zmolnar/g-track/hardware/KiCad/v1.0/g-track_.html

## KiBoM PCB Bill of Materials

Source File | /home/zmolnar/development/KiCad/g-track/g-track/g-track.sch
BoM Date | 2019. febr. 6., szerda, 18:45:01 CET
Schematic Version
Schematic Date
KiCad Version | Eeschema 5.0.2-bee76a0~70~ubuntu18.04.1
Component Groups | 61
Component Count (per PCB) | 101
Fitted Components (per PCB) | 101
Number of PCBs | 1
Total Component Count (for 1 PCBs) | 101

## Component Groups

KiCad Fields (default)

Generated Fields

User Fields

Empty Fields

| Description | Part | References | Value | Footprint | Quantity Per PCB | Datasheet | Lomex | Farnell
1 | Unpolarized capacitor, small symbol | C_Small | C13 C18 C19 C20 C21 C23 C25 C27 | 100nF | C_0603_1608Metric_Pad1.05x0.95mm_HandSolder | 8 | ~ | 82-06-23 82-03-47
2 | Unpolarized capacitor, small symbol | C_Small | C5 C14 C32 | 100nF | C_0805_2012Metric_Pad1.15x1.40mm_HandSolder | 3 | ~ | ? 82-01-75
3 | Unpolarized capacitor, small symbol | C_Small | C30 | 100nF/50V | C_0805_2012Metric_Pad1.15x1.40mm_HandSolder | 1 | ~ | 82-01-75
4 | Unpolarized capacitor, small symbol | C_Small | C26 | 10uF | C_0603_1608Metric_Pad1.05x0.95mm_HandSolder | 1 | ~ | 82-11-15
5 | Unpolarized capacitor, small symbol | C_Small | C1 C17 C29 | 10uF/25V | C_1206_3216Metric_Pad1.42x1.75mm_HandSolder | 3 | ~ | 82-07-90
6 | Unpolarized capacitor, small symbol | C_Small | C9 C10 | 12pF | C_0603_1608Metric_Pad1.05x0.95mm_HandSolder | 2 | ~ | 82-12-68
7 | Unpolarized capacitor, small symbol | C_Small | C4 | 15nF | C_0805_2012Metric_Pad1.15x1.40mm_HandSolder | 1 | ~ | 82-01-22
8 | Unpolarized capacitor, small symbol | C_Small | C22 C24 | 1uF | C_0603_1608Metric_Pad1.05x0.95mm_HandSolder | 2 | ~ | 82-06-81
9 | Unpolarized capacitor, small symbol | C_Small | C28 | 2.2uF | C_0805_2012Metric_Pad1.15x1.40mm_HandSolder | 1 | ~ | 82-04-35
10 | Unpolarized capacitor, small symbol | C_Small | C2 | 220pF | C_0805_2012Metric_Pad1.15x1.40mm_HandSolder | 1 | ~ | 82-05-54
11 | Unpolarized capacitor, small symbol | C_Small | C11 C12 | 22pF | C_0603_1608Metric_Pad1.05x0.95mm_HandSolder | 2 | ~ | 82-06-55
12 | Unpolarized capacitor, small symbol | C_Small | C7 C33 | 470nF | C_0805_2012Metric_Pad1.15x1.40mm_HandSolder | 2 | ~ | 82-06-60
13 | Polarized capacitor, small US symbol | CP1_Small | C6 | 470uF | CP_Elec_8x10 | 1 | ~ | 91-00-97
14 | Polarized capacitor, small US symbol | CP1_Small | C8 C31 C34 | 47uF | CP_EIA-3528-21_Kemet-B_Pad1.50x2.35mm_HandSolder | 3 | ~ | 92-01-24
15 | Unpolarized capacitor, small symbol | C_Small | C3 | 56pF | C_0805_2012Metric_Pad1.15x1.40mm_HandSolder | 1 | ~ | 82-01-00
16 | Schottky diode | D_Schottky | D1 D4 | B340A | D_SMA | 2 | ~ | | 2748288
17 | Light emitting diode | LED | D2 D3 D6 | GREEN | D_0603_1608Metric_Pad1.05x0.95mm_HandSolder | 3 | ~
18 | 100V 0.1A Small Signal Schottky diode, MiniMELF | LL41 | D7 | LL46 | D_MiniMELF | 1 | http://www.vishay.com/docs/85659/bat41.pdf
19 | Light emitting diode | LED | D8 | RED | D_0603_1608Metric_Pad1.05x0.95mm_HandSolder | 1 | ~
20 | Generic connector, single row, 01x04, script generated (kicad-library-utils/schlib/autogen/connector/) | Conn_01x04 | J4 | DCM | Tianli_TLPHC100R_1x04_P3.81mm_Horizontal | 1 | ~ | 43-27-91
21 | Generic connector, single row, 01x10, script generated (kicad-library-utils/schlib/autogen/connector/) | Conn_01x10 | J5 | EXT | Tianli_TLPHC100R_1x10_P3.81mm_Horizontal | 1 | ~
22 | Generic connector, single row, 01x08, script generated (kicad-library-utils/schlib/autogen/connector/) | Conn_01x08 | J8 | LIS3DSH | PinHeader_1x08_P2.54mm_Vertical | 1 | ~
23 | Micro SD Card Socket with card detection pins | Micro_SD_Card_Det | J3 | Micro SD card | microSD_HC_Hirose_DM3AT-SF-PEJM5 | 1 | https://www.hirose.com/product/en/download_file/key_name/DM3/category/Catalog/doc_file_id/49662/?item_id=195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 | | 1764374
24 | Generic connector, single row, 01x06, script generated (kicad-library-utils/schlib/autogen/connector/) | Conn_01x06 | J1 | SWD | PinSocket_1x06_P2.54mm_Vertical | 1 | ~
25 | USB Mini Type B connector | USB_B_Mini | J2 | USB_B_Mini | USB_Mini-B_Lumberg_2486_01_Horizontal | 1 | ~
26 | expansion header for Raspberry Pi 2 & 3 | Raspberry_Pi_2_3 | J6 | Waveshare GSM/GPS/GNSS | Waveshare_GSM_GPS_GNSS_hat | 1 | https://www.raspberrypi.org/documentation/hardware/raspberrypi/schematics/rpi_SCH_3bplus_1p0_reduced.pdf
27 | Jumper, 3-pole, both open | Jumper_3_Open | JP3 | ACC_SPI_SELECT | PinHeader_1x03_P1.00mm_Vertical | 1 | ~
28 | Jumper, 3-pole, both open | Jumper_3_Open | JP1 | Power source | PinHeader_1x03_P2.54mm_Vertical | 1 | ~
29 | Solder Jumper, 3-pole, open | SolderJumper_3_Open | JP2 | Protection | SolderJumper-3_P2.0mm_Open_TrianglePad1.0x1.5mm_NumberLabels | 1 | ~
30 | Capacitor symbol for simulation only | INDUCTOR | L1 | 22uH | L_Bourns_SRR1260 | 1 | ~ | | 2374126
31 | 0.115A Id, 60V Vds, N-channel MOSFET, SOT-23 | 2N7002 | Q1 Q2 | 2N7002 | SOT-23 | 2 | https://www.fairchildsemi.com/datasheets/2N/2N7002.pdf
32 | Resistor, small symbol | R_Small | R30 R31 | 0R47 | R_0805_2012Metric_Pad1.15x1.40mm_HandSolder | 2 | ~ | 80-18-24
33 | Resistor, small symbol | R_Small | R21 | 100k | R_0805_2012Metric_Pad1.15x1.40mm_HandSolder | 1 | ~ | 81-34-64
34 | Resistor | R | R6 R15 R22 R26 R27 R28 R29 R39 R40 | 10k | R_0805_2012Metric_Pad1.15x1.40mm_HandSolder | 9 | ~ | 80-52-96
35 | Resistor, small symbol | R_Small | R8 | 10k | R_0603_1608Metric_Pad1.05x0.95mm_HandSolder | 1 | ~ | 81-10-38
36 | Resistor, small symbol | R_Small | R2 R35 R36 R37 | 15k | R_0805_2012Metric_Pad1.15x1.40mm_HandSolder | 4 | ~ | 80-11-00
37 | Resistor, small symbol | R_Small | R14 | 160R | R_0805_2012Metric_Pad1.15x1.40mm_HandSolder | 1 | ~ | 80-01-97
38 | Resistor | R | R7 | 1k91 | R_0805_2012Metric_Pad1.15x1.40mm_HandSolder | 1 | ~ | | 2138373
39 | Resistor, small symbol | R_Small | R32 R33 R34 | 2k | R_0805_2012Metric_Pad1.15x1.40mm_HandSolder | 3 | ~ | 80-36-87
40 | Resistor, small symbol | R_Small | R10 R11 R25 R38 | 330R | R_0805_2012Metric_Pad1.15x1.40mm_HandSolder | 4 | ~ | 80-32-56
41 | Resistor, small symbol | R_Small | R3 | 332k | R_0805_2012Metric_Pad1.15x1.40mm_HandSolder | 1 | ~ | 80-03-06
42 | Resistor, small symbol | R_Small | R23 | 33k | R_0805_2012Metric_Pad1.15x1.40mm_HandSolder | 1 | ~ | 81-11-05
43 | Resistor, small symbol | R_Small | R9 | 390R | R_0603_1608Metric_Pad1.05x0.95mm_HandSolder | 1 | ~ | 81-10-21
44 | Resistor, small symbol | R_Small | R5 | 40k2 | R_0805_2012Metric_Pad1.15x1.40mm_HandSolder | 1 | ~ | | 2139000
45 | Resistor, small symbol | R_Small | R20 | 510R | R_0805_2012Metric_Pad1.15x1.40mm_HandSolder | 1 | ~ | 81-11-87
46 | Resistor, small symbol | R_Small | R24 | 68k | R_0805_2012Metric_Pad1.15x1.40mm_HandSolder | 1 | ~ | 81-11-09
47 | Resistor, small symbol | R_Small | R4 | 68k1 | R_0805_2012Metric_Pad1.15x1.40mm_HandSolder | 1 | ~ | 80-06-36
48 | Resistor, small symbol | R_Small | R1 | 75k | R_0805_2012Metric_Pad1.15x1.40mm_HandSolder | 1 | ~ | 80-11-32
49 | Push button switch, generic, two pins | SW_Push | SW2 | BT0 | SW_SPST_PTS645 | 1 | | | 2320087
50 | Push button switch, generic, two pins | SW_Push | SW1 | Reset | SW_SPST_PTS645 | 1 | | | 2320087
51 | DC Optocoupler Base Connected, Vce 70V, CTR 100-200%, Viso 5000V (RMS), DIP6 | CNY17-3 | U8 U9 U10 | CNY17-3 | SMDIP-6_W9.53mm | 3 | http://www.vishay.com/docs/83606/cny17.pdf
52 | Dual H-Bridge motor driver, PWM controlled, single/dual brushed DC stepper, +2 to +18 VDD, TSSOP-16 | DRV8848 | U7 | DRV8848 | TSSOP-16-1EP_4.4x5mm_P0.65mm | 1 | http://www.ti.com/lit/ds/symlink/drv8848.pdf
53 | KINGSTATE - KSSGJ4B20 - MAGNETIC TRANSDUCER, SMD TYPE | KSSGJ4B20 | U4 | KSSGJ4B20 | KSSGJ4B20 | 1 | http://www.farnell.com/datasheets/97523.pdf
54 | | LIS3DSH | U6 | LIS3DSH | LGA-16_3x3mm_P0.5mm_LayoutBorder3x5y | 1 | https://www.st.com/resource/en/datasheet/lis3dsh.pdf
55 | | LM2940IMP* | U11 | LM2940IMP* | SOT-223-3_TabPin2 | 1 | http://www.ti.com/lit/ds/symlink/lm3940.pdf | | 1469075
56 | | LM3940IMP* | U2 | LM3940IMP* | SOT-223-3_TabPin2 | 1 | http://www.ti.com/lit/gpn/lm3940 | | 1469104
57 | ARM Cortex-M4 MCU, 256KB flash, 160KB RAM, 80MHz, 1.71-3.6V, 52 GPIO, LQFP-64 | STM32L452RCTx | U3 | STM32L452RCTx | LQFP-64_10x10mm_P0.5mm | 1 | http://www.st.com/st-web-ui/static/active/en/resource/technical/document/datasheet/DM00340549.pdf
58 | 2A, Step Down DC-DC Converter with Eco-mode, 3.5-28V Input Voltage, SO-8 | TPS54233 | U1 | TPS54233 | SOIC-8_3.9x4.9mm_P1.27mm | 1 | http://www.ti.com/lit/ds/symlink/tps54233.pdf | | 1755639
59 | Bidirectional ESD Protection Diode, SOT-23-6 | USBLC6-2SC6 | U5 | USBLC6-2SC6 | SOT-23-6 | 1 | http://www2.st.com/resource/en/datasheet/CD00050750.pdf | | 1269406
60 | Three pin crystal, GND on pin 3, small symbol | Crystal_GND3_Small | Y1 | 32.768kHz | Crystal_AT310_D3.0mm_L10.0mm_Horizontal_1EP_style1 | 1 | ~ | 40-00-93
61 | Two pin crystal, small symbol | Crystal_Small | Y2 | 8MHz | Crystal_HC49-U_Vertical | 1 | ~ | 40-01-16
