zmolnar/g-track/software/TODO.txt

* add RTC
* add dashboard
* implement chain oiler thread
* add LIS3DSH driver
* add phone call handler
* add position reporter
* add bluetooth manager
