zmolnar/g-track/hardware/KiCad/v1.0/g-track.kicad_pcb

## KiCad design hardware/KiCad/v1.0/g-track.kicad_pcb (2019-02-28)

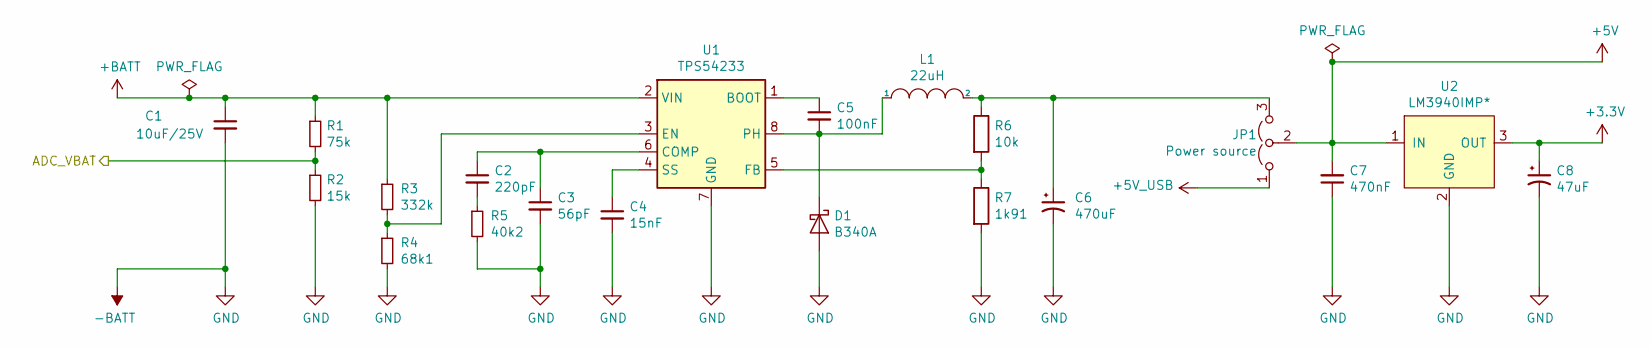
[picture p14: schematic PowerSupply.sch, Power supply]

Parts:
C1: 10uF/25V; C_1206_3216Metric_Pad1.42x1.75mm_HandSolder
C2: 220pF; C_0805_2012Metric_Pad1.15x1.40mm_HandSolder
C3: 56pF; C_0805_2012Metric_Pad1.15x1.40mm_HandSolder
C4: 15nF; C_0805_2012Metric_Pad1.15x1.40mm_HandSolder
C5: 100nF; C_0805_2012Metric_Pad1.15x1.40mm_HandSolder
C6: 470uF; CP_Elec_8x10
C7: 470nF; C_0805_2012Metric_Pad1.15x1.40mm_HandSolder
C8: 47uF; CP_EIA-3528-21_Kemet-B_Pad1.50x2.35mm_HandSolder
D1: B340A; D_SMA; Farnell 2748288
JP1: Power source; PinHeader_1x03_P2.54mm_Vertical
L1: 22uH; L_Bourns_SRR1260; Farnell 2374126
R1: 75k; R_0805_2012Metric_Pad1.15x1.40mm_HandSolder
R2: 15k; R_0805_2012Metric_Pad1.15x1.40mm_HandSolder
R3: 332k; R_0805_2012Metric_Pad1.15x1.40mm_HandSolder
R4: 68k1; R_0805_2012Metric_Pad1.15x1.40mm_HandSolder
R5: 40k2; R_0805_2012Metric_Pad1.15x1.40mm_HandSolder; Farnell 2139000
R6: 10k; R_0805_2012Metric_Pad1.15x1.40mm_HandSolder
R7: 1k91; R_0805_2012Metric_Pad1.15x1.40mm_HandSolder; Farnell 2138373
U1: TPS54233; SOIC-8_3.9x4.9mm_P1.27mm; Farnell 1755639
U2: LM3940IMP*; SOT-223-3_TabPin2; Farnell 1469104

Connections:
+3V3: C8.1, U2.3 (OUT); also elsewhere on the board
+5V: C7.2, JP1.2 (C), U2.1 (IN); also elsewhere on the board
+5V_USB: JP1.1 (A); also elsewhere on the board
+BATT: C1.1, R1.1, R3.1, U1.2 (VIN); also elsewhere on the board
-BATT: C1.2, C3.2, C4.2, C6.2, C7.1, C8.2, D1.2 (A), R2.2, R4.2, R5.2, R7.2, U1.7 (GND), U2.2 (GND); also elsewhere on the board
/Sheet5C1D43B5/ADC_VBAT: R1.2, R2.1; also elsewhere on the board
unnamed: C2.1, C3.1, U1.6 (COMP)
unnamed: C2.2, R5.1
unnamed: C4.1, U1.4 (SS)
unnamed: C5.1, U1.1 (BOOT)
unnamed: C5.2, D1.1 (K), L1.1, U1.8 (PH)
unnamed: C6.1, JP1.3 (B), L1.2, R6.1
unnamed: R3.2, R4.1, U1.3 (EN)
unnamed: R6.2, R7.1, U1.5 (FB)

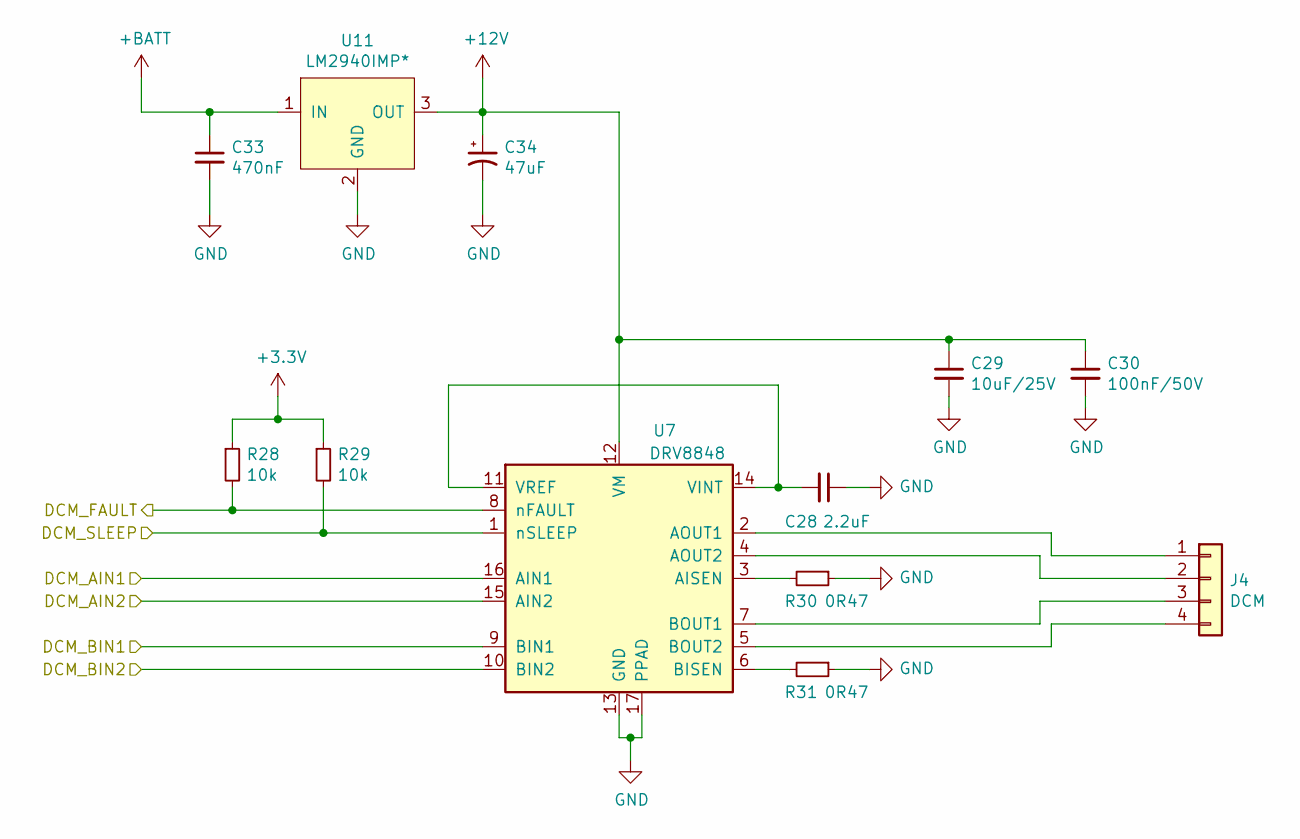
[picture p15: schematic MotorDriver.sch]

Parts:
C28: 2.2uF; C_0805_2012Metric_Pad1.15x1.40mm_HandSolder
C29: 10uF/25V; C_1206_3216Metric_Pad1.42x1.75mm_HandSolder
C30: 100nF/50V; C_0805_2012Metric_Pad1.15x1.40mm_HandSolder
C33: 470nF; C_0805_2012Metric_Pad1.15x1.40mm_HandSolder
C34: 47uF; CP_EIA-3528-21_Kemet-B_Pad1.50x2.35mm_HandSolder
J4: DCM; Tianli_TLPHC100R_1x04_P3.81mm_Horizontal
R28, R29: 10k; R_0805_2012Metric_Pad1.15x1.40mm_HandSolder
R30, R31: 0R47; R_0805_2012Metric_Pad1.15x1.40mm_HandSolder
U7: DRV8848; TSSOP-16-1EP_4.4x5mm_P0.65mm
U11: LM2940IMP*; SOT-223-3_TabPin2; Farnell 1469075

Connections:
+3V3: R28.1, R29.1; also elsewhere on the board
+12V: C29.1, C30.1, C34.1, U7.12 (VM), U11.3 (OUT)
+BATT: C33.1, U11.1 (IN); also elsewhere on the board
-BATT: C28.1, C29.2, C30.2, C33.2, C34.2, R30.1, R31.1, U7.13 (GND), U7.17 (PPAD), U11.2 (GND); also elsewhere on the board
/DC motor driver/DCM_AIN1: U7.16 (AIN1); also elsewhere on the board
/DC motor driver/DCM_AIN2: U7.15 (AIN2); also elsewhere on the board
/DC motor driver/DCM_BIN1: U7.9 (BIN1); also elsewhere on the board
/DC motor driver/DCM_BIN2: U7.10 (BIN2); also elsewhere on the board
/DC motor driver/DCM_FAULT: R28.2, U7.8 (nFAULT); also elsewhere on the board
/DC motor driver/DCM_SLEEP: R29.2, U7.1 (nSLEEP); also elsewhere on the board
unnamed: C28.2, U7.11 (VREF), U7.14 (VINT)
unnamed: J4.1, U7.2 (AOUT1)
unnamed: J4.2, U7.4 (AOUT2)
unnamed: J4.3, U7.7 (BOUT1)
unnamed: J4.4, U7.5 (BOUT2)
unnamed: R30.2, U7.3 (AISEN)
unnamed: R31.2, U7.6 (BISEN)

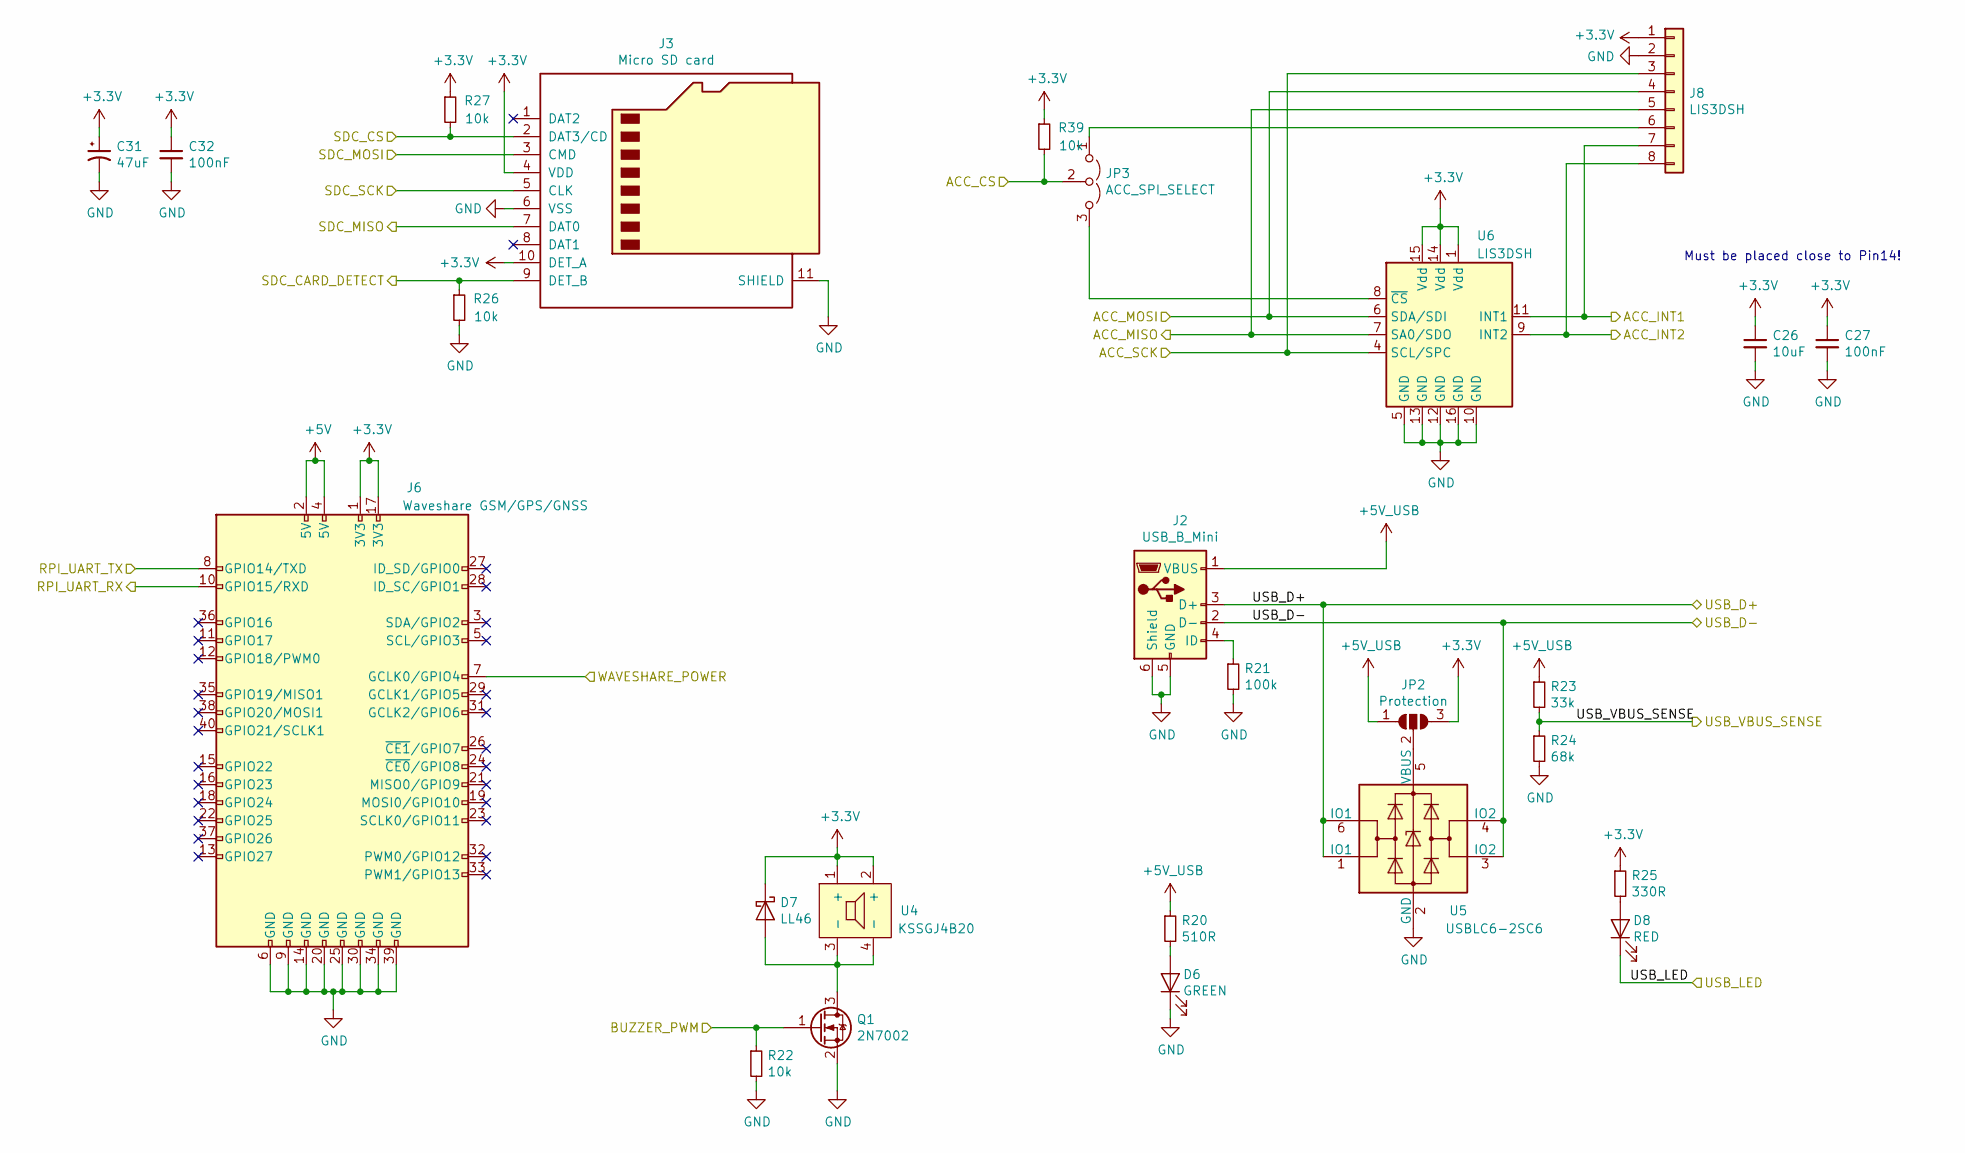
[picture p16: schematic peripherals.sch]

Parts:
C26: 10uF; C_0603_1608Metric_Pad1.05x0.95mm_HandSolder
C27: 100nF; C_0603_1608Metric_Pad1.05x0.95mm_HandSolder
C31: 47uF; CP_EIA-3528-21_Kemet-B_Pad1.50x2.35mm_HandSolder
C32: 100nF; C_0805_2012Metric_Pad1.15x1.40mm_HandSolder
D6: GREEN; D_0603_1608Metric_Pad1.05x0.95mm_HandSolder
D7: LL46; D_MiniMELF
D8: RED; D_0603_1608Metric_Pad1.05x0.95mm_HandSolder
J2: USB_B_Mini; USB_Mini-B_Lumberg_2486_01_Horizontal
J3: Micro SD card; microSD_HC_Hirose_DM3AT-SF-PEJM5; Farnell 1764374
J6: Waveshare GSM/GPS/GNSS; Waveshare_GSM_GPS_GNSS_hat
J8: LIS3DSH; PinHeader_1x08_P2.54mm_Vertical
JP2: Protection; SolderJumper-3_P2.0mm_Open_TrianglePad1.0x1.5mm_NumberLabels
JP3: ACC_SPI_SELECT; PinHeader_1x03_P1.00mm_Vertical
Q1: 2N7002; SOT-23
R20: 510R; R_0805_2012Metric_Pad1.15x1.40mm_HandSolder
R21: 100k; R_0805_2012Metric_Pad1.15x1.40mm_HandSolder
R22, R26, R27, R39: 10k; R_0805_2012Metric_Pad1.15x1.40mm_HandSolder
R23: 33k; R_0805_2012Metric_Pad1.15x1.40mm_HandSolder
R24: 68k; R_0805_2012Metric_Pad1.15x1.40mm_HandSolder
R25: 330R; R_0805_2012Metric_Pad1.15x1.40mm_HandSolder
U4: KSSGJ4B20
U5: USBLC6-2SC6; SOT-23-6; Farnell 1269406
U6: LIS3DSH; LGA-16_3x3mm_P0.5mm_LayoutBorder3x5y

Connections:
+3V3: C26.1, C27.1, C31.1, C32.1, D7.1 (K), J3.4 (VDD), J3.10 (DET_A), J6.1 (3V3), J6.17 (3V3), J8.1, JP2.3 (B), R25.1, R27.1, R39.1, U4.1 (+), U4.2 (+), U6.1 (Vdd), U6.14 (Vdd), U6.15 (Vdd); also elsewhere on the board
+5V: J6.2 (5V), J6.4 (5V); also elsewhere on the board
+5V_USB: J2.1 (VBUS), JP2.1 (A), R20.1, R23.1; also elsewhere on the board
-BATT: C26.2, C27.2, C31.2, C32.2, D6.1 (K), J2.5 (GND), J2.6 (Shield), J3.6 (VSS), J3.11 (SHIELD), J6.6 (GND), J6.9 (GND), J6.14 (GND), J6.20 (GND), J6.25 (GND), J6.30 (GND), J6.34 (GND), J6.39 (GND), J8.2, Q1.2 (S), R21.2, R22.2, R24.2, R26.2, U5.2 (GND), U6.5 (GND), U6.10 (GND), U6.12 (GND), U6.13 (GND), U6.16 (GND); also elsewhere on the board
/Peripherals/ACC_CS: JP3.2 (C), R39.2; also elsewhere on the board
/Peripherals/ACC_INT1: J8.7, U6.11 (INT1); also elsewhere on the board
/Peripherals/ACC_INT2: J8.8, U6.9 (INT2); also elsewhere on the board
/Peripherals/ACC_MISO: J8.5, U6.7 (SA0/SDO); also elsewhere on the board
/Peripherals/ACC_MOSI: J8.4, U6.6 (SDA/SDI); also elsewhere on the board
/Peripherals/ACC_SCK: J8.3, U6.4 (SCL/SPC); also elsewhere on the board
/Peripherals/BUZZER_PWM: Q1.1 (G), R22.1; also elsewhere on the board
/Peripherals/RPI_UART_RX: J6.10 (GPIO15/RXD); also elsewhere on the board
/Peripherals/RPI_UART_TX: J6.8 (GPIO14/TXD); also elsewhere on the board
/Peripherals/SDC_CARD_DETECT: J3.9 (DET_B), R26.1; also elsewhere on the board
/Peripherals/SDC_CS: J3.2 (DAT3/CD), R27.2; also elsewhere on the board
/Peripherals/SDC_MISO: J3.7 (DAT0); also elsewhere on the board
/Peripherals/SDC_MOSI: J3.3 (CMD); also elsewhere on the board
/Peripherals/SDC_SCK: J3.5 (CLK); also elsewhere on the board
/Peripherals/USB_D+: J2.3 (D+), U5.1 (IO1), U5.6 (IO1); also elsewhere on the board
/Peripherals/USB_D-: J2.2 (D-), U5.3 (IO2), U5.4 (IO2); also elsewhere on the board
/Peripherals/USB_LED: D8.1 (K); also elsewhere on the board
/Peripherals/USB_VBUS_SENSE: R23.2, R24.1; also elsewhere on the board
/Peripherals/WAVESHARE_POWER: J6.7 (GCLK0/GPIO4); also elsewhere on the board
unnamed: D6.2 (A), R20.2
unnamed: D7.2 (A), Q1.3 (D), U4.3 (-), U4.4 (-)
unnamed: D8.2 (A), R25.2
unnamed: J2.4 (ID), R21.1
unnamed: J8.6, JP3.1 (A)
unnamed: JP2.2 (C), U5.5 (VBUS)
unnamed: JP3.3 (B), U6.8 (~CS)

Notes on the sheet:
Must be placed close to Pin14!

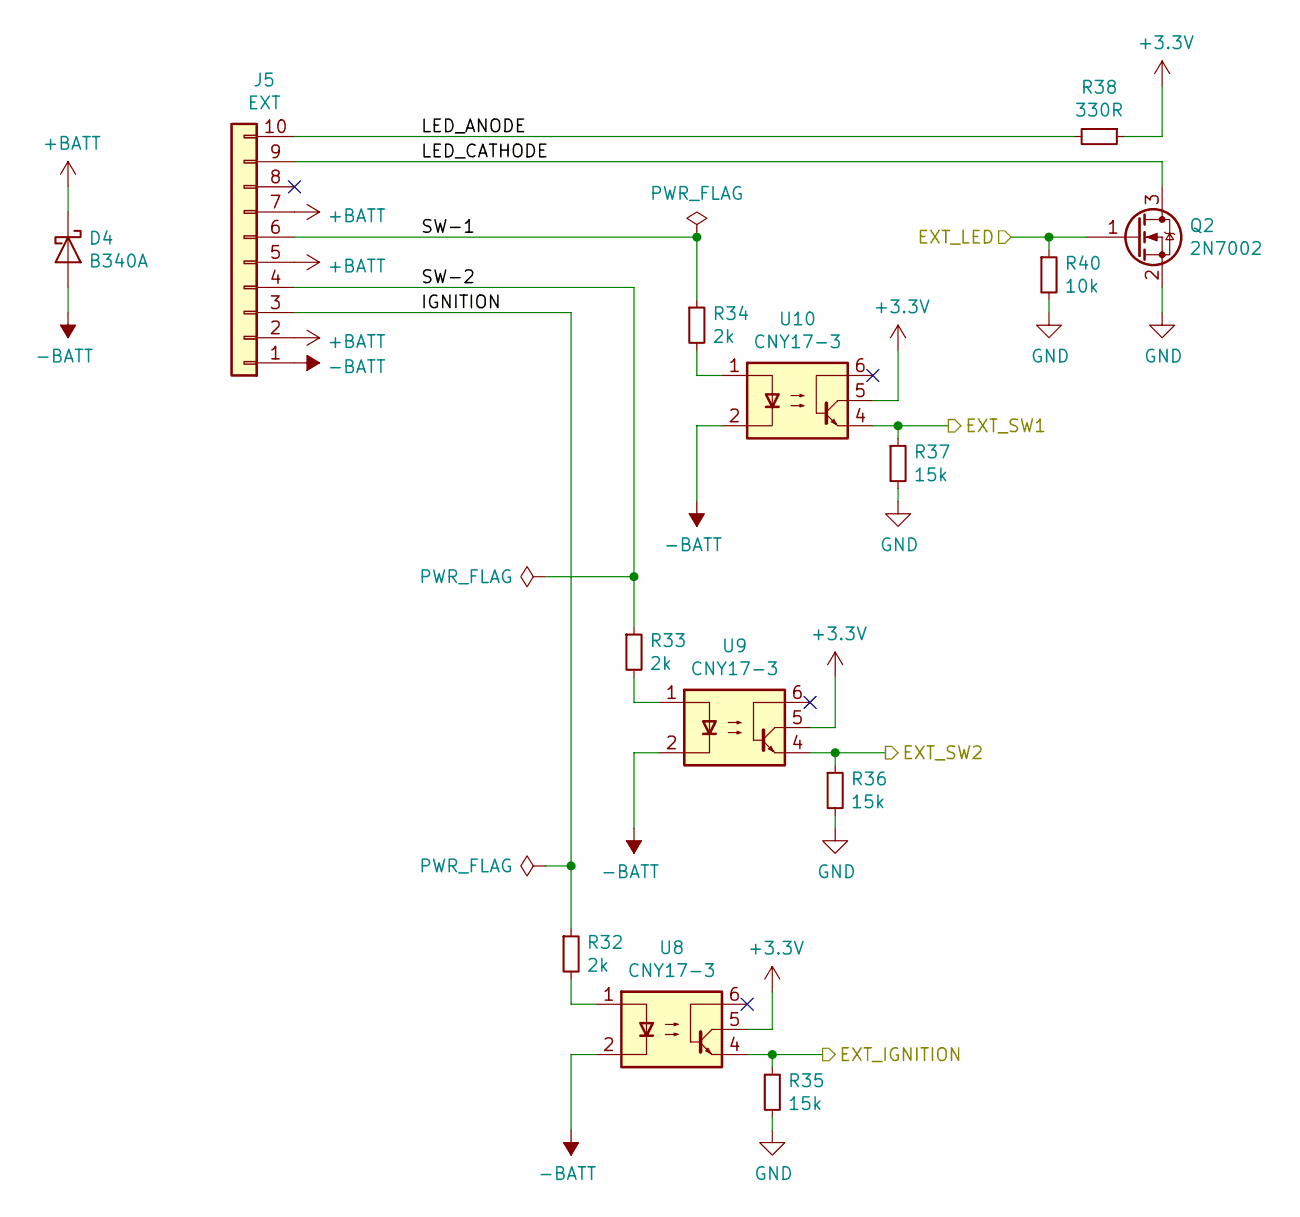
[picture p17: schematic External.sch]

Parts:
D4: B340A; D_SMA; Farnell 2748288
J5: EXT; Tianli_TLPHC100R_1x10_P3.81mm_Horizontal
Q2: 2N7002; SOT-23
R32, R33, R34: 2k; R_0805_2012Metric_Pad1.15x1.40mm_HandSolder
R35, R36, R37: 15k; R_0805_2012Metric_Pad1.15x1.40mm_HandSolder
R38: 330R; R_0805_2012Metric_Pad1.15x1.40mm_HandSolder
R40: 10k; R_0805_2012Metric_Pad1.15x1.40mm_HandSolder
U8, U9, U10: CNY17-3; SMDIP-6_W9.53mm

Connections:
+3V3: R38.1, U8.5, U9.5, U10.5; also elsewhere on the board
+BATT: D4.1 (K), J5.2, J5.5, J5.7; also elsewhere on the board
-BATT: D4.2 (A), J5.1, Q2.2 (S), R35.2, R36.2, R37.2, R40.2, U8.2, U9.2, U10.2; also elsewhere on the board
/External/EXT_IGNITION: R35.1, U8.4; also elsewhere on the board
/External/EXT_LED: Q2.1 (G), R40.1; also elsewhere on the board
/External/EXT_SW1: R37.1, U10.4; also elsewhere on the board
/External/EXT_SW2: R36.1, U9.4; also elsewhere on the board
/External/IGNITION: J5.3, R32.1
/External/LED_ANODE: J5.10, R38.2
/External/LED_CATHODE: J5.9, Q2.3 (D)
/External/SW-1: J5.6, R34.1
/External/SW-2: J5.4, R33.1
unnamed: R32.2, U8.1
unnamed: R33.2, U9.1
unnamed: R34.2, U10.1

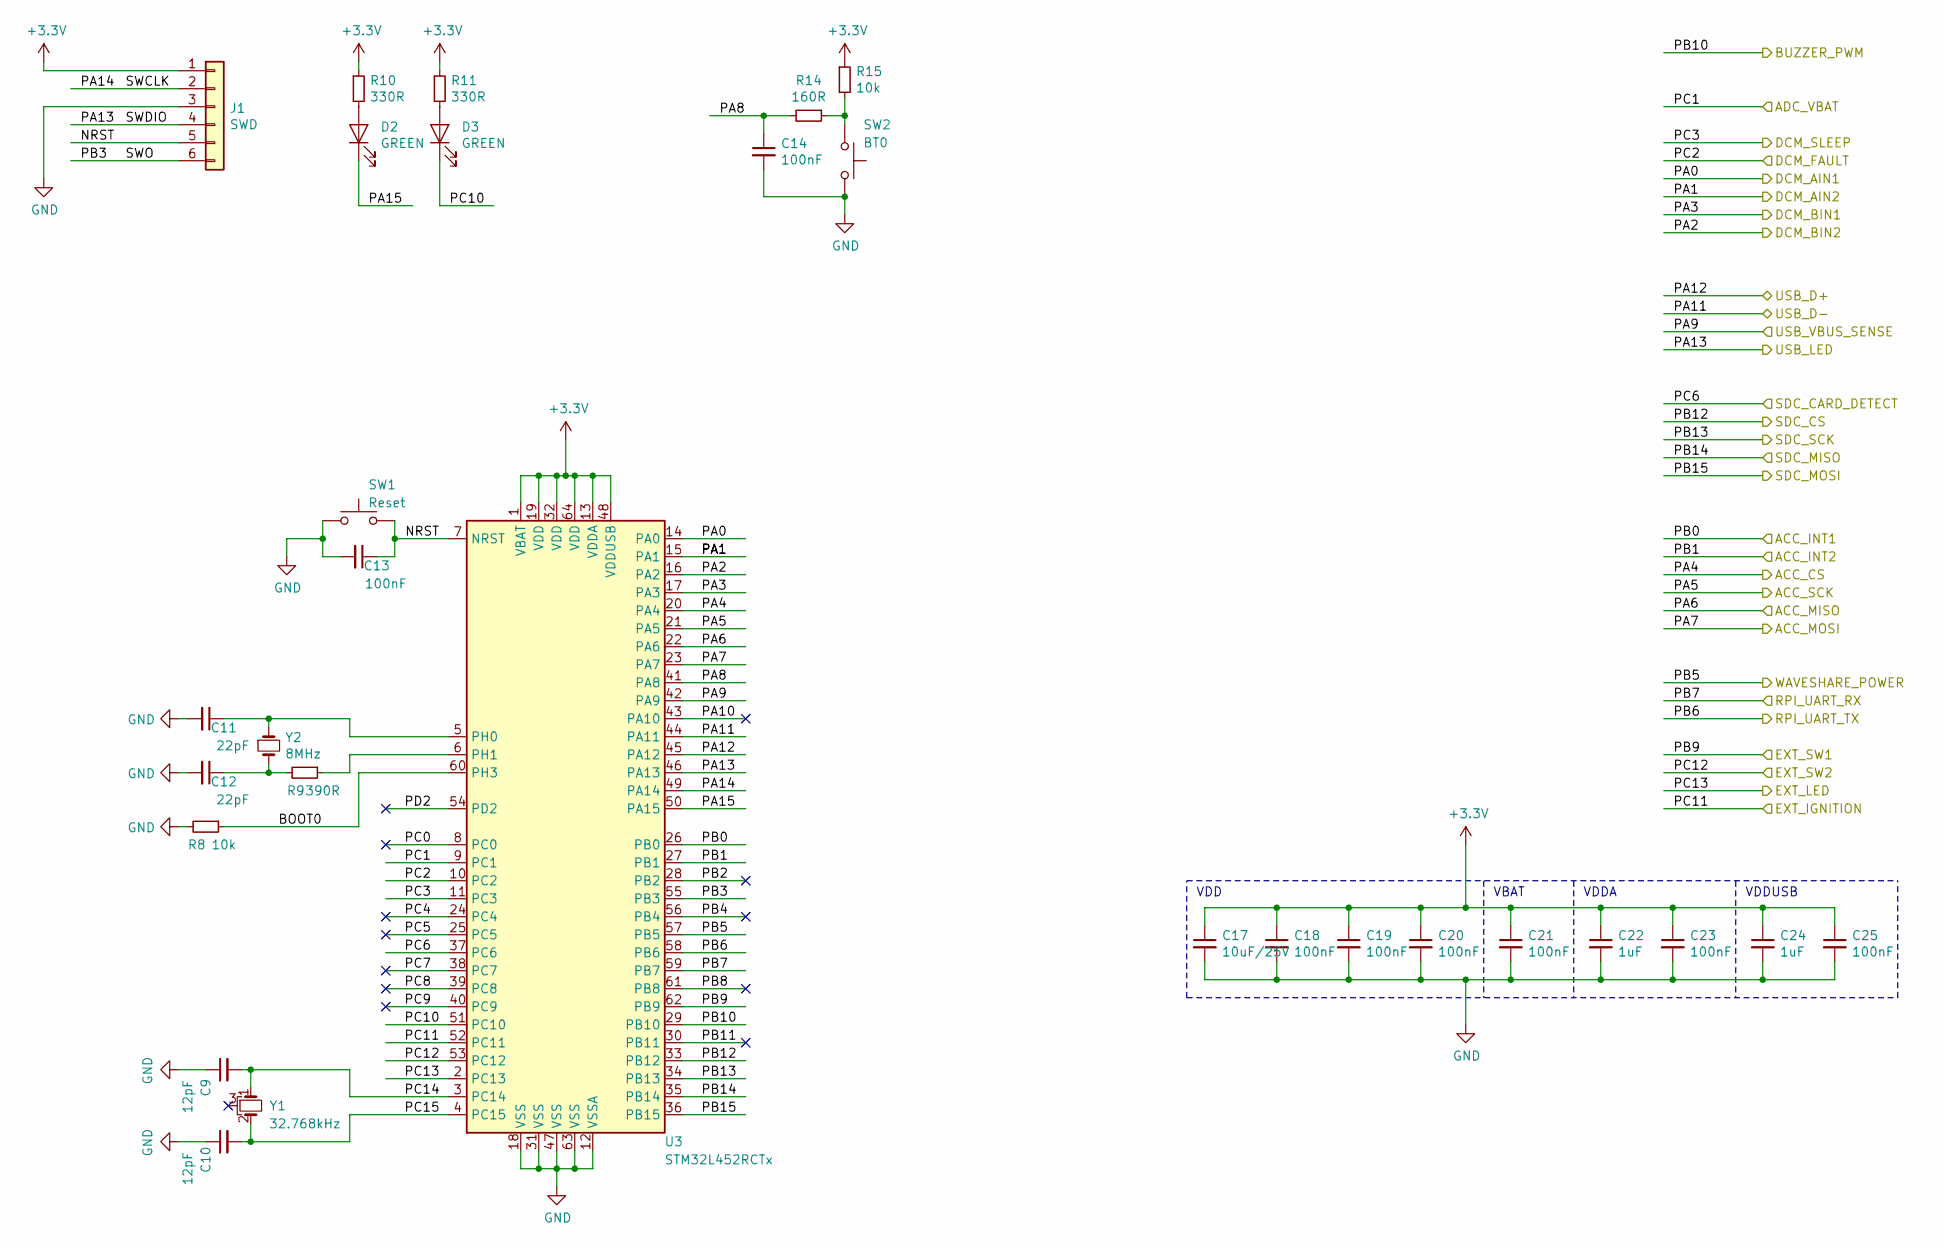
[picture p18: schematic mcu.sch, Microcontroller Unit]

Parts:
C9, C10: 12pF; C_0603_1608Metric_Pad1.05x0.95mm_HandSolder
C11, C12: 22pF; C_0603_1608Metric_Pad1.05x0.95mm_HandSolder
C13, C18, C19, C20, C21, C23, C25: 100nF; C_0603_1608Metric_Pad1.05x0.95mm_HandSolder
C14: 100nF; C_0805_2012Metric_Pad1.15x1.40mm_HandSolder
C17: 10uF/25V; C_1206_3216Metric_Pad1.42x1.75mm_HandSolder
C22, C24: 1uF; C_0603_1608Metric_Pad1.05x0.95mm_HandSolder
D2, D3: GREEN; D_0603_1608Metric_Pad1.05x0.95mm_HandSolder
J1: SWD; PinSocket_1x06_P2.54mm_Vertical
R8: 10k; R_0603_1608Metric_Pad1.05x0.95mm_HandSolder
R9: 390R; R_0603_1608Metric_Pad1.05x0.95mm_HandSolder
R10, R11: 330R; R_0805_2012Metric_Pad1.15x1.40mm_HandSolder
R14: 160R; R_0805_2012Metric_Pad1.15x1.40mm_HandSolder
R15: 10k; R_0805_2012Metric_Pad1.15x1.40mm_HandSolder
SW1: Reset; SW_SPST_PTS645; Farnell 2320087
SW2: BT0; SW_SPST_PTS645; Farnell 2320087
U3: STM32L452RCTx; LQFP-64_10x10mm_P0.5mm
Y1: 32.768kHz; Crystal_AT310_D3.0mm_L10.0mm_Horizontal_1EP_style1
Y2: 8MHz; Crystal_HC49-U_Vertical

Connections:
+3V3: C17.1, C18.1, C19.1, C20.1, C21.1, C22.1, C23.1, C24.1, C25.1, J1.1, R10.1, R11.1, R15.1, U3.1 (VBAT), U3.13 (VDDA), U3.19 (VDD), U3.32 (VDD), U3.48 (VDDUSB), U3.64 (VDD); also elsewhere on the board
-BATT: C9.1, C10.1, C11.2, C12.2, C13.2, C14.2, C17.2, C18.2, C19.2, C20.2, C21.2, C22.2, C23.2, C24.2, C25.2, J1.3, R8.2, SW1.1, SW2.2, U3.12 (VSSA), U3.18 (VSS), U3.31 (VSS), U3.47 (VSS), U3.63 (VSS); also elsewhere on the board
/DC motor driver/DCM_AIN1: U3.14 (PA0); also elsewhere on the board
/DC motor driver/DCM_AIN2: U3.15 (PA1); also elsewhere on the board
/DC motor driver/DCM_BIN1: U3.17 (PA3); also elsewhere on the board
/DC motor driver/DCM_BIN2: U3.16 (PA2); also elsewhere on the board
/DC motor driver/DCM_FAULT: U3.10 (PC2); also elsewhere on the board
/DC motor driver/DCM_SLEEP: U3.11 (PC3); also elsewhere on the board
/External/EXT_IGNITION: U3.52 (PC11); also elsewhere on the board
/External/EXT_LED: U3.2 (PC13); also elsewhere on the board
/External/EXT_SW1: U3.62 (PB9); also elsewhere on the board
/External/EXT_SW2: U3.53 (PC12); also elsewhere on the board
/Peripherals/ACC_CS: U3.20 (PA4); also elsewhere on the board
/Peripherals/ACC_INT1: U3.26 (PB0); also elsewhere on the board
/Peripherals/ACC_INT2: U3.27 (PB1); also elsewhere on the board
/Peripherals/ACC_MISO: U3.22 (PA6); also elsewhere on the board
/Peripherals/ACC_MOSI: U3.23 (PA7); also elsewhere on the board
/Peripherals/ACC_SCK: U3.21 (PA5); also elsewhere on the board
/Peripherals/BUZZER_PWM: U3.29 (PB10); also elsewhere on the board
/Peripherals/RPI_UART_RX: U3.59 (PB7); also elsewhere on the board
/Peripherals/RPI_UART_TX: U3.58 (PB6); also elsewhere on the board
/Peripherals/SDC_CARD_DETECT: U3.37 (PC6); also elsewhere on the board
/Peripherals/SDC_CS: U3.33 (PB12); also elsewhere on the board
/Peripherals/SDC_MISO: U3.35 (PB14); also elsewhere on the board
/Peripherals/SDC_MOSI: U3.36 (PB15); also elsewhere on the board
/Peripherals/SDC_SCK: U3.34 (PB13); also elsewhere on the board
/Peripherals/USB_D+: U3.45 (PA12); also elsewhere on the board
/Peripherals/USB_D-: U3.44 (PA11); also elsewhere on the board
/Peripherals/USB_LED: J1.4, U3.46 (PA13); also elsewhere on the board
/Peripherals/USB_VBUS_SENSE: U3.42 (PA9); also elsewhere on the board
/Peripherals/WAVESHARE_POWER: U3.57 (PB5); also elsewhere on the board
/Sheet5C1D43B5/ADC_VBAT: U3.9 (PC1); also elsewhere on the board
/mcu/BOOT0: R8.1, U3.60 (PH3)
/mcu/NRST: C13.1, J1.5, SW1.2, U3.7 (NRST)
/mcu/PA8: C14.1, R14.2, U3.41 (PA8)
/mcu/PA10: U3.43 (PA10)
/mcu/PA14: J1.2, U3.49 (PA14)
/mcu/PA15: D2.1 (K), U3.50 (PA15)
/mcu/PB2: U3.28 (PB2)
/mcu/PB3: J1.6, U3.55 (PB3)
/mcu/PB4: U3.56 (PB4)
/mcu/PB8: U3.61 (PB8)
/mcu/PB11: U3.30 (PB11)
/mcu/PC0: U3.8 (PC0)
/mcu/PC4: U3.24 (PC4)
/mcu/PC5: U3.25 (PC5)
/mcu/PC7: U3.38 (PC7)
/mcu/PC8: U3.39 (PC8)
/mcu/PC9: U3.40 (PC9)
/mcu/PC10: D3.1 (K), U3.51 (PC10)
/mcu/PC14: C9.2, U3.3 (PC14), Y1.1
/mcu/PC15: C10.2, U3.4 (PC15), Y1.2
/mcu/PD2: U3.54 (PD2)
unnamed: C11.1, U3.5 (PH0), Y2.1
unnamed: C12.1, R9.2, Y2.2
unnamed: D2.2 (A), R10.2
unnamed: D3.2 (A), R11.2
unnamed: R9.1, U3.6 (PH1)
unnamed: R14.1, R15.2, SW2.1

Notes on the sheet:
VDD
VDDA
VBAT
VDDUSB

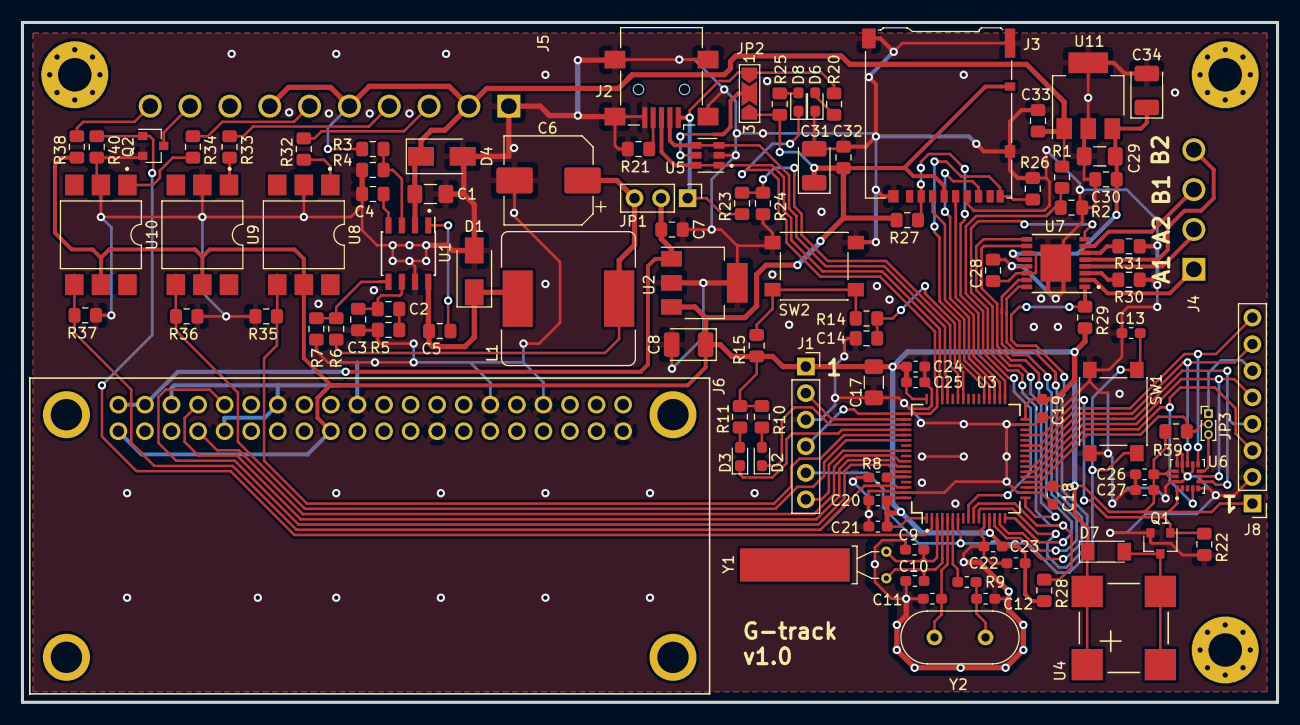
[picture p19: board g-track.kicad_pcb from above]

Board: 2 copper layers, 120.0 x 65.0 mm, 101 parts (0 on the bottom side), 81 nets.
