zmolnar/g-track/software/source/DebugShell.c

/**
 * @file DebugShell.c
 * @brief
 */

/*******************************************************************************/
/* INCLUDES                                                                    */
/*******************************************************************************/
#include "DebugShell.h"
#include "ch.h"
#include "hal.h"
#include "chprintf.h"
#include "Sdcard.h"
#include "usbcfg.h"

/*******************************************************************************/
/* DEFINED CONSTANTS                                                           */
/*******************************************************************************/
 #define SHELL_WA_SIZE   THD_WORKING_AREA_SIZE(2048)

/*******************************************************************************/
/* TYPE DEFINITIONS                                                            */
/*******************************************************************************/

/*******************************************************************************/
/* MACRO DEFINITIONS                                                           */
/*******************************************************************************/

/*******************************************************************************/
/* DEFINITION OF GLOBAL CONSTANTS AND VARIABLES                                */
/*******************************************************************************/
static thread_reference_t shelltp;

static const ShellCommand commands[] = {
  {"tree", sdcardCmdTree},
  {NULL, NULL}
};

static const ShellConfig usb_shell_cfg = {
  (BaseSequentialStream *)&SDU1,
  commands
};

/*******************************************************************************/
/* DECLARATION OF LOCAL FUNCTIONS                                              */
/*******************************************************************************/

/*******************************************************************************/
/* DEFINITION OF LOCAL FUNCTIONS                                               */
/*******************************************************************************/

/*******************************************************************************/
/* DEFINITION OF GLOBAL FUNCTIONS                                              */
/*******************************************************************************/
void debugShellInit(void) {
  sduObjectInit(&SDU1);
  shellInit();
  usbDisconnectBus(serusbcfg.usbp);
  chThdSleepMilliseconds(1000);
}

void debugShellStart(void) {
  sduStart(&SDU1, &serusbcfg);
  usbStart(serusbcfg.usbp, &usbcfg);
  usbConnectBus(serusbcfg.usbp);
  chThdSleepMilliseconds(500);

  if (!shelltp) {
    shelltp = chThdCreateFromHeap(NULL, SHELL_WA_SIZE,
                                  "usbshell", NORMALPRIO + 1,
                                  shellThread, (void *)&usb_shell_cfg);
  }
}

void debugShellStop() {
  if (shelltp && chThdTerminatedX(shelltp)) {
    chThdWait(shelltp);   
    shelltp = NULL;
  }
  
  usbDisconnectBus(serusbcfg.usbp);
  usbStop(serusbcfg.usbp);
  sduStop(&SDU1);
}

void debugShellTerminated(void) {
  if (chThdTerminatedX(shelltp)) {
    chThdWait(shelltp);   
    shelltp = NULL;
  } 
}

/******************************* END OF FILE ***********************************/
