zmolnar/g-track/software/source/BoardEvents.c

/**
 * @file BoardEvents.c
 * @brief
 */

/*******************************************************************************/
/* INCLUDES                                                                    */
/*******************************************************************************/
#include "BoardEvents.h"

/*******************************************************************************/
/* DEFINED CONSTANTS                                                           */
/*******************************************************************************/

/*******************************************************************************/
/* TYPE DEFINITIONS                                                            */
/*******************************************************************************/

/*******************************************************************************/
/* MACRO DEFINITIONS                                                           */
/*******************************************************************************/

/*******************************************************************************/
/* DEFINITION OF GLOBAL CONSTANTS AND VARIABLES                                */
/*******************************************************************************/
event_source_t besSdcardInserted;
event_source_t besSdcardRemoved;
event_source_t besUsbConnected;
event_source_t besUsbDisconnected;
event_source_t besIgnitionOn;
event_source_t besIgnitionOff;

/*******************************************************************************/
/* DECLARATION OF LOCAL FUNCTIONS                                              */
/*******************************************************************************/

/*******************************************************************************/
/* DEFINITION OF LOCAL FUNCTIONS                                               */
/*******************************************************************************/

/*******************************************************************************/
/* DEFINITION OF GLOBAL FUNCTIONS                                              */
/*******************************************************************************/
void boardEventsInit(void) {
    chEvtObjectInit(&besSdcardInserted);
    chEvtObjectInit(&besSdcardRemoved);
    chEvtObjectInit(&besUsbConnected);
    chEvtObjectInit(&besUsbDisconnected);
    chEvtObjectInit(&besIgnitionOn);
    chEvtObjectInit(&besIgnitionOff);
}

/******************************* END OF FILE ***********************************/
