zmolnar/g-track/software/source/BoardEvents.h

/**
 * @file BoardEvents.h
 * @brief
 */

#ifndef BOARD_EVENTS_H
#define BOARD_EVENTS_H

/*******************************************************************************/
/* INCLUDES                                                                    */
/*******************************************************************************/
#include "ch.h"

/*******************************************************************************/
/* DEFINED CONSTANTS                                                           */
/*******************************************************************************/

/*******************************************************************************/
/* MACRO DEFINITIONS                                                           */
/*******************************************************************************/

/*******************************************************************************/
/* TYPE DEFINITIONS                                                            */
/*******************************************************************************/

/*******************************************************************************/
/* DECLARATION OF GLOBAL VARIABLES                                             */
/*******************************************************************************/
extern event_source_t besSdcardInserted;
extern event_source_t besSdcardRemoved;
extern event_source_t besUsbConnected;
extern event_source_t besUsbDisconnected;
extern event_source_t besIgnitionOn;
extern event_source_t besIgnitionOff;

/*******************************************************************************/
/* DECLARATION OF GLOBAL FUNCTIONS                                             */
/*******************************************************************************/
void boardEventsInit(void);

#endif /* BOARD_EVENTS_H */

/******************************* END OF FILE ***********************************/
