zmolnar/g-track/software/source/BoardMonitorThread.h

/**
 * @file BoardMonitorThread.h
 * @brief Thread to handle board events.
*/

#ifndef BOARD_MONITOR_THREAD_H
#define BOARD_MONITOR_THREAD_H

/*******************************************************************************/
/* INCLUDES                                                                    */
/*******************************************************************************/
#include "ch.h"

/*******************************************************************************/
/* DEFINED CONSTANTS                                                           */
/*******************************************************************************/

/*******************************************************************************/
/* MACRO DEFINITIONS                                                           */
/*******************************************************************************/

/*******************************************************************************/
/* TYPE DEFINITIONS                                                            */
/*******************************************************************************/

/*******************************************************************************/
/* DECLARATION OF GLOBAL VARIABLES                                             */
/*******************************************************************************/

/*******************************************************************************/
/* DECLARATION OF GLOBAL FUNCTIONS                                             */
/*******************************************************************************/
THD_FUNCTION(BoardMonitorThread, arg);
void BoardMonitorThreadInit(void);

#endif /* BOARD_MONITOR_THREAD_H */

/******************************* END OF FILE ***********************************/
