zmolnar/g-track/software/source/SystemThread.h

/**
 * @file SystemThread.h
 * @brief G-track system state machine handler thread.
 */

#ifndef SYSTEM_THREAD_H
#define SYSTEM_THREAD_H

/*******************************************************************************/
/* INCLUDES                                                                    */
/*******************************************************************************/
#include "ch.h"

/*******************************************************************************/
/* DEFINED CONSTANTS                                                           */
/*******************************************************************************/

/*******************************************************************************/
/* MACRO DEFINITIONS                                                           */
/*******************************************************************************/

/*******************************************************************************/
/* TYPE DEFINITIONS                                                            */
/*******************************************************************************/
typedef enum {
  SYS_EVT_IGNITION_ON,
  SYS_EVT_IGNITION_OFF
} SystemEvent_t;

/*******************************************************************************/
/* DECLARATION OF GLOBAL VARIABLES                                             */
/*******************************************************************************/
extern mailbox_t systemMailbox;

/*******************************************************************************/
/* DECLARATION OF GLOBAL FUNCTIONS                                             */
/*******************************************************************************/
THD_FUNCTION(SystemThread, arg);
void SystemThreadInit(void);

#endif /* SYSTEM_THREAD_H */

/******************************* END OF FILE ***********************************/
