zmolnar/g-track/(commit log)

2019-02-12 Add ChibiOS 18.2.x 5b8695ccbd8388b7ac880d57fb1fdbc9a0d4c6ca to the project. Add STM32L432 demo project as a base.
    [stm_spc56ec74a256s_spc56ec74_minimodule_debug_jtag.cfg, stm_xpc560b64_minimodule_debug_jtag.cfg, stm_xpc560b_spc560d40_minimodule_debug_jtag.cfg, stm_xpc560p_minimodule_40mhz_debug_jtag.cfg, stm_xpc563m64_minimodule_debug_jtag.cfg, stm_xpc564a_spc564a70_minimodule_debug_jtag.cfg, stm_xpc56el_minimodule_lockstep_debug_jtag.cfg]
2019-02-28 Add v1.0 hardware design docs.
    [External.sch, MotorDriver.sch, PowerSupply.sch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]
2019-03-05 Add support for STM32L452RC MCU. Not tested.
2019-03-20 Add USB serial port driver and shell thread.
2019-03-25 Add SD-card over SPI support.
    [mkfs.xls]
2019-03-26 Refactor threads and code structure.
2019-03-28 Add first implementation of SIM8xx modem driver.
2019-04-01 Manage control signal to reset the waveshare modem.
    [board.h]
2019-04-10 Fix GPIO setup for SDC data pins.
    [board.h]
2019-05-12 Move hardware design files to v1.0 directory.
    [External.sch, MotorDriver.sch, PowerSupply.sch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]
2019-05-15 Add corrections to fix compilation errors.
    [GpsReaderThread.c]
